www666www6661/WEILAI_SuperCap/hardware/SuperCap_Power/SuperCap_Power.kicad_pcb

## KiCad design hardware/SuperCap_Power/SuperCap_Power.kicad_pcb (2026-07-01)

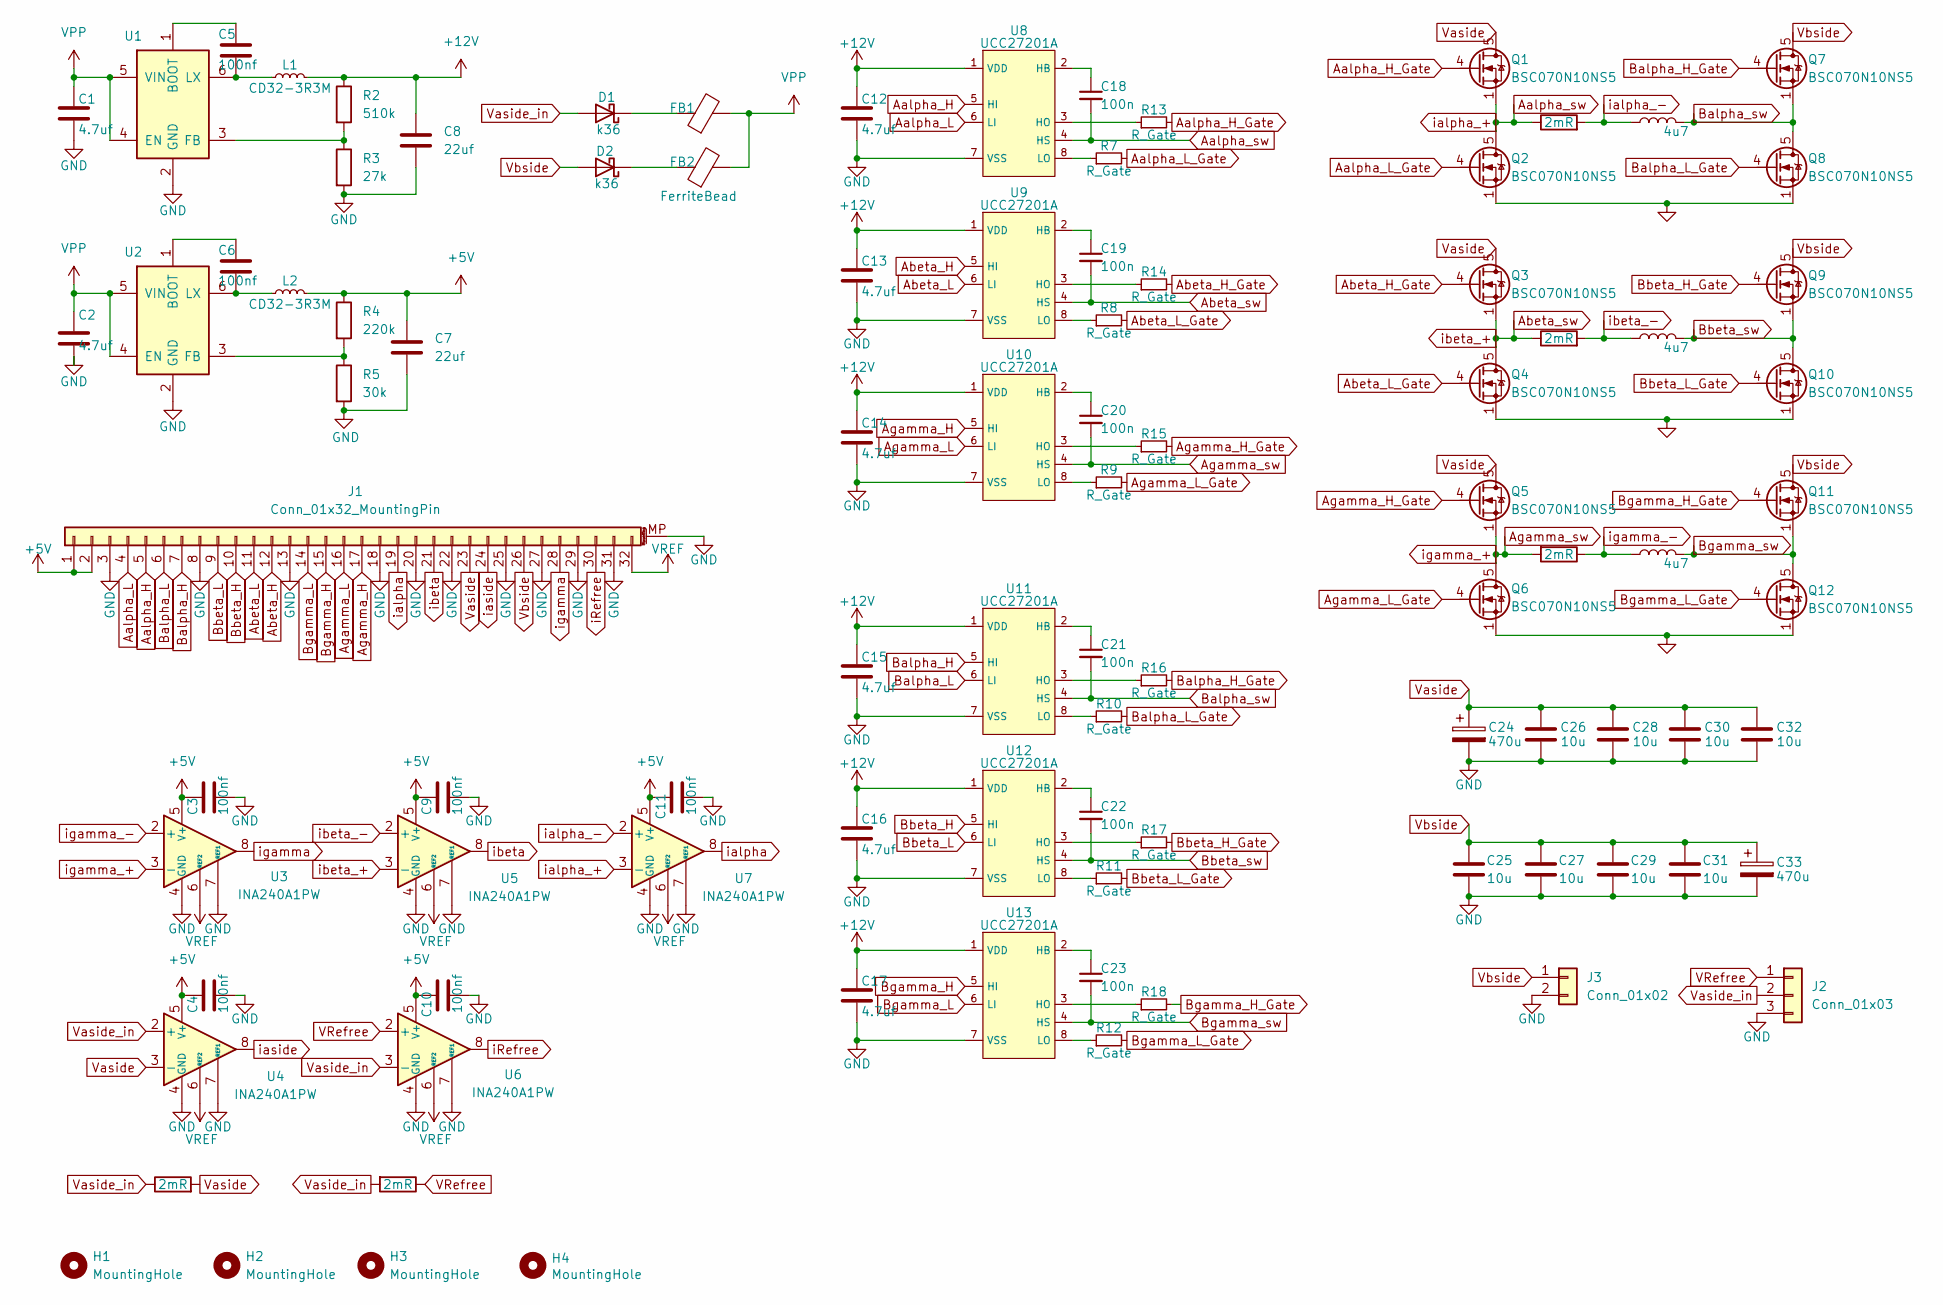
[picture p1: schematic SuperCap_Power.kicad_sch]

Parts:
C1, C2: 4.7uf; C_0805_2012Metric
C3, C4, C5, C6, C9, C10, C11: 100nf; C_0603_1608Metric_Pad1.08x0.95mm_HandSolder
C7, C8: 22uf; C_0603_1608Metric_Pad1.08x0.95mm_HandSolder
C12, C13, C14, C15, C16, C17: 4.7uf; C_0603_1608Metric_Pad1.08x0.95mm_HandSolder
C18, C19, C20, C21, C22, C23: 100n; C_0603_1608Metric
C24, C33: 470u; C_Radial_D10.0mm_H20.0mm_P5.00mm
C25, C26, C27, C28, C29, C30, C31, C32: 10u; C_1206_3216Metric
D1, D2: k36; D_SOD-123F
FB1, FB2: FerriteBead; L_0603_1608Metric
H1, H2, H3, H4: MountingHole; MountingHole_3.2mm_M3
J1: Conn_01x32_MountingPin; Hirose_FH12-32S-0.5SH_1x32-1MP_P0.50mm_Horizontal
J2: Conn_01x03; 1_03
J3: Conn_01x02; 01_02
L1, L2: CD32-3R3M; tolerance 20 %; MPN CD32-3R3M
L3, L4, L5: 4u7; L_Bourns_SRP1050WA
Q1, Q2, Q3, Q4, Q5, Q6, Q7, Q8, Q9, Q10, Q11, Q12: BSC070N10NS5; TDSON-8-1
R1, R6, R19, R20, R21: 2mR; R_0612_1632Metric
R2: 510k; R_0603_1608Metric_Pad0.98x0.95mm_HandSolder
R3: 27k; R_0603_1608Metric_Pad0.98x0.95mm_HandSolder
R4: 220k; R_0603_1608Metric_Pad0.98x0.95mm_HandSolder
R5: 30k; R_0603_1608Metric_Pad0.98x0.95mm_HandSolder
R7, R8, R9, R10, R11, R12, R13, R14, R15, R16, R17, R18: R_Gate; R_0603_1608Metric
U1, U2: ME3121AM6G; SOT-23-6; MPN ME3121AM6G
U3, U4, U5, U6, U7: INA240A1PW; TSSOP-8_4.4x3mm_P0.65mm
U8, U9, U10, U11, U12, U13: UCC27201A; SOIC-8_3.9x4.9mm_P1.27mm

Connections:
+5V: C3.2, C4.2, C7.2, C9.2, C10.2, C11.2, J1.1, J1.2, L2.2, R4.1, U3.5 (V+), U4.5 (V+), U5.5 (V+), U6.5 (V+), U7.5 (V+)
+12V: C8.2, C12.1, C13.1, C14.1, C15.1, C16.1, C17.1, L1.2, R2.1, U8.1 (VDD), U9.1 (VDD), U10.1 (VDD), U11.1 (VDD), U12.1 (VDD), U13.1 (VDD)
Aalpha_H: J1.5, U8.5 (HI)
Aalpha_H_Gate: Q1.4 (G), R13.2
Aalpha_L: J1.4, U8.6 (LI)
Aalpha_L_Gate: Q2.4 (G), R7.2
Aalpha_sw: C18.2, Q1.1 (S), Q1.2 (S), Q1.3 (S), Q2.5 (D), R19.1, U7.3 (-), U8.4 (HS)
Abeta_H: J1.12, U9.5 (HI)
Abeta_H_Gate: Q3.4 (G), R14.2
Abeta_L: J1.11, U9.6 (LI)
Abeta_L_Gate: Q4.4 (G), R8.2
Abeta_sw: C19.2, Q3.1 (S), Q3.2 (S), Q3.3 (S), Q4.5 (D), R20.1, U5.3 (-), U9.4 (HS)
Agamma_H: J1.17, U10.5 (HI)
Agamma_H_Gate: Q5.4 (G), R15.2
Agamma_L: J1.16, U10.6 (LI)
Agamma_L_Gate: Q6.4 (G), R9.2
Agamma_sw: C20.2, Q5.1 (S), Q5.2 (S), Q5.3 (S), Q6.5 (D), R21.2, U3.3 (-), U10.4 (HS)
Balpha_H: J1.7, U11.5 (HI)
Balpha_H_Gate: Q7.4 (G), R16.2
Balpha_L: J1.6, U11.6 (LI)
Balpha_L_Gate: Q8.4 (G), R10.2
Balpha_sw: C21.2, L3.2, Q7.1 (S), Q7.2 (S), Q7.3 (S), Q8.5 (D), U11.4 (HS)
Bbeta_H: J1.10, U12.5 (HI)
Bbeta_H_Gate: Q9.4 (G), R17.2
Bbeta_L: J1.9, U12.6 (LI)
Bbeta_L_Gate: Q10.4 (G), R11.2
Bbeta_sw: C22.2, L4.2, Q9.1 (S), Q9.2 (S), Q9.3 (S), Q10.5 (D), U12.4 (HS)
Bgamma_H: J1.15, U13.5 (HI)
Bgamma_H_Gate: Q11.4 (G), R18.2
Bgamma_L: J1.14, U13.6 (LI)
Bgamma_L_Gate: Q12.4 (G), R12.2
Bgamma_sw: C23.2, L5.2, Q11.1 (S), Q11.2 (S), Q11.3 (S), Q12.5 (D), U13.4 (HS)
GND: C1.2, C2.2, C3.1, C4.1, C7.1, C8.1, C9.1, C10.1, C11.1, C12.2, C13.2, C14.2, C15.2, C16.2, C17.2, C24.2, C25.1, C26.1, C27.1, C28.1, C29.1, C30.1, C31.1, C32.1, C33.2, J1.3, J1.8, J1.13, J1.18, J1.20, J1.22, J1.25, J1.27, J1.29, J1.31, J1.MP (MountPin), J2.3, J3.2, Q2.1 (S), Q2.2 (S), Q2.3 (S), Q4.1 (S), Q4.2 (S), Q4.3 (S), Q6.1 (S), Q6.2 (S), Q6.3 (S), Q8.1 (S), Q8.2 (S), Q8.3 (S), Q10.1 (S), Q10.2 (S), Q10.3 (S), Q12.1 (S), Q12.2 (S), Q12.3 (S), R3.2, R5.2, U1.2 (GND), U2.2 (GND), U3.1 (GND), U3.4 (GND), U3.7 (REF1), U4.1 (GND), U4.4 (GND), U4.7 (REF1), U5.1 (GND), U5.4 (GND), U5.7 (REF1), U6.1 (GND), U6.4 (GND), U6.7 (REF1), U7.1 (GND), U7.4 (GND), U7.7 (REF1), U8.7 (VSS), U9.7 (VSS), U10.7 (VSS), U11.7 (VSS), U12.7 (VSS), U13.7 (VSS)
unnamed: D1.1 (K), FB1.1
unnamed: D2.1 (K), FB2.1
unnamed: C5.2, U1.1 (BOOT)
unnamed: R2.2, R3.1, U1.3 (FB)
unnamed: C5.1, L1.1, U1.6 (LX)
unnamed: C6.2, U2.1 (BOOT)
unnamed: R4.2, R5.1, U2.3 (FB)
unnamed: C6.1, L2.1, U2.6 (LX)
unnamed: C18.1, U8.2 (HB)
unnamed: R13.1, U8.3 (HO)
unnamed: R7.1, U8.8 (LO)
unnamed: C19.1, U9.2 (HB)
unnamed: R14.1, U9.3 (HO)
unnamed: R8.1, U9.8 (LO)
unnamed: C20.1, U10.2 (HB)
unnamed: R15.1, U10.3 (HO)
unnamed: R9.1, U10.8 (LO)
unnamed: C21.1, U11.2 (HB)
unnamed: R16.1, U11.3 (HO)
unnamed: R10.1, U11.8 (LO)
unnamed: C22.1, U12.2 (HB)
unnamed: R17.1, U12.3 (HO)
unnamed: R11.1, U12.8 (LO)
unnamed: C23.1, U13.2 (HB)
unnamed: R18.1, U13.3 (HO)
unnamed: R12.1, U13.8 (LO)
VPP: C1.1, C2.1, FB1.2, FB2.2, U1.4 (EN), U1.5 (VIN), U2.4 (EN), U2.5 (VIN)
VREF: J1.32, U3.6 (REF2), U4.6 (REF2), U5.6 (REF2), U6.6 (REF2), U7.6 (REF2)
VRefree: J2.1, R6.1, U6.2 (+)
Vaside: C24.1, C26.2, C28.2, C30.2, C32.2, J1.23, Q1.5 (D), Q3.5 (D), Q5.5 (D), R1.2, U4.3 (-)
Vaside_in: D1.2 (A), J2.2, R1.1, R6.2, U4.2 (+), U6.3 (-)
Vbside: C25.2, C27.2, C29.2, C31.2, C33.1, D2.2 (A), J1.26, J3.1, Q7.5 (D), Q9.5 (D), Q11.5 (D)
iRefree: J1.30, U6.8
ialpha: J1.19, U7.8
ialpha_-: L3.1, R19.2, U7.2 (+)
iaside: J1.24, U4.8
ibeta: J1.21, U5.8
ibeta_-: L4.1, R20.2, U5.2 (+)
igamma: J1.28, U3.8
igamma_-: L5.1, R21.1, U3.2 (+)

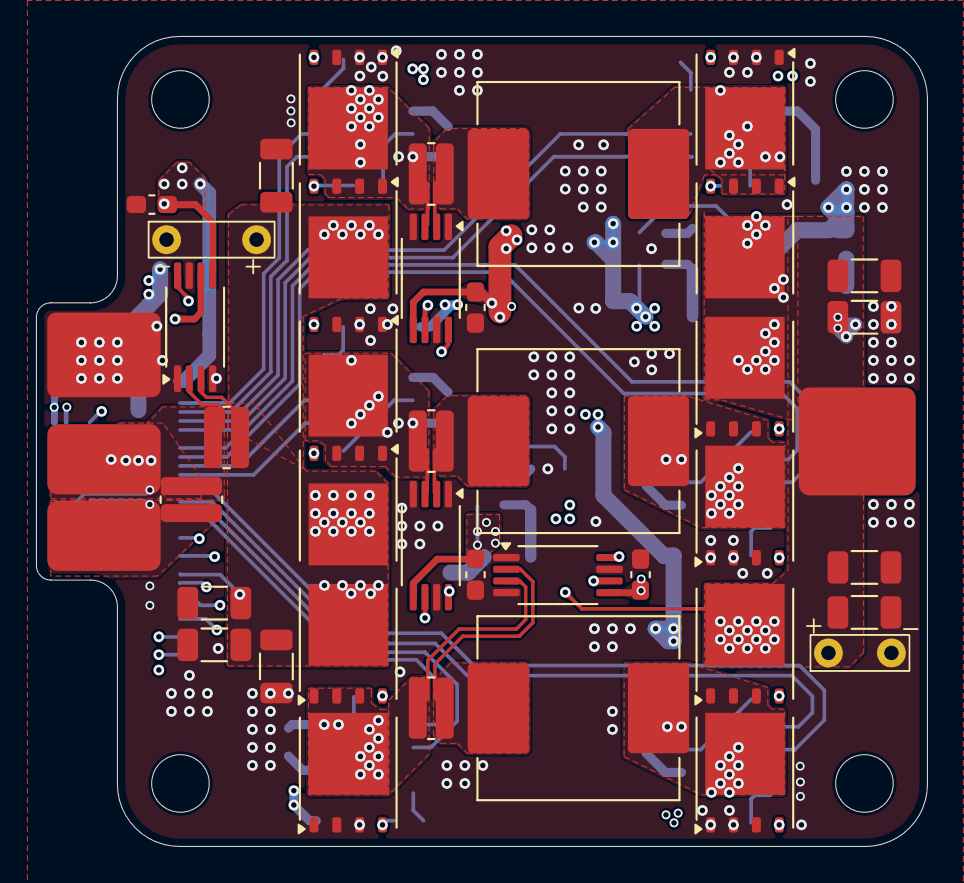
[picture p2: board SuperCap_Power.kicad_pcb from above]

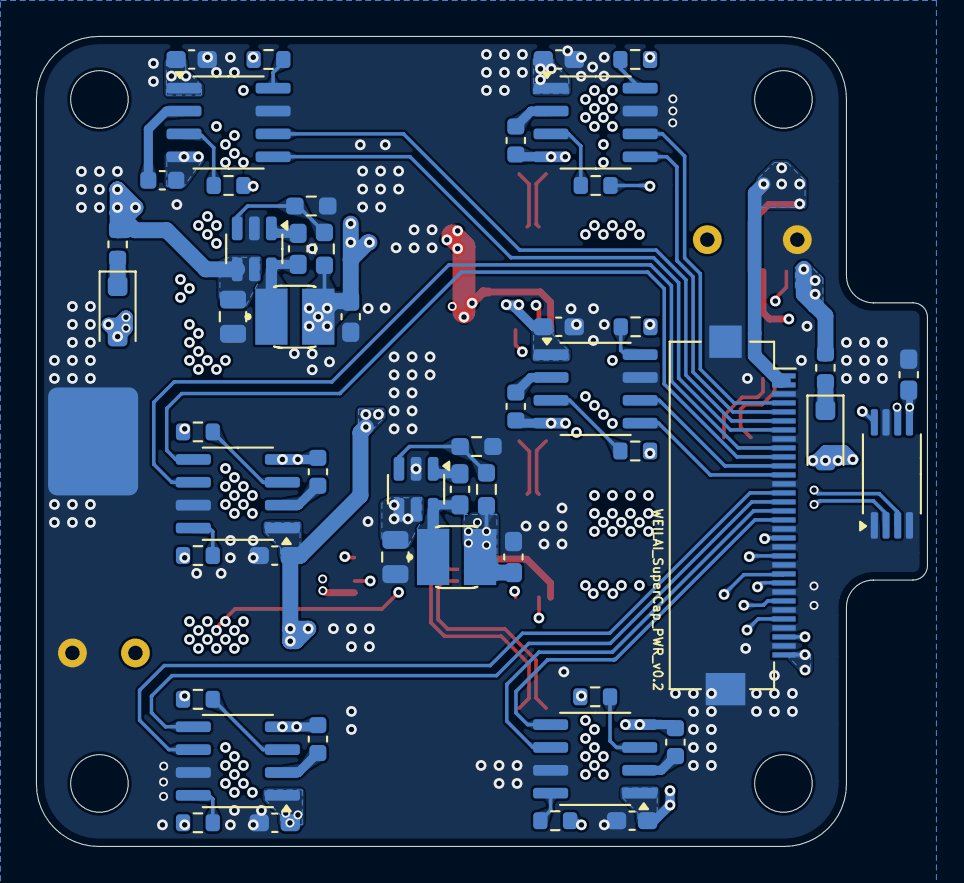
[picture p3: board SuperCap_Power.kicad_pcb from below]

Board: 4 copper layers, 49.5 x 45.0 mm, 95 parts (51 on the bottom side), 73 nets.
