www666www6661/WEILAI_SuperCap/hardware/SuperCap_Ctrl/SuperCap_Ctrl.kicad_pcb

## KiCad design hardware/SuperCap_Ctrl/SuperCap_Ctrl.kicad_pcb (2026-07-01)

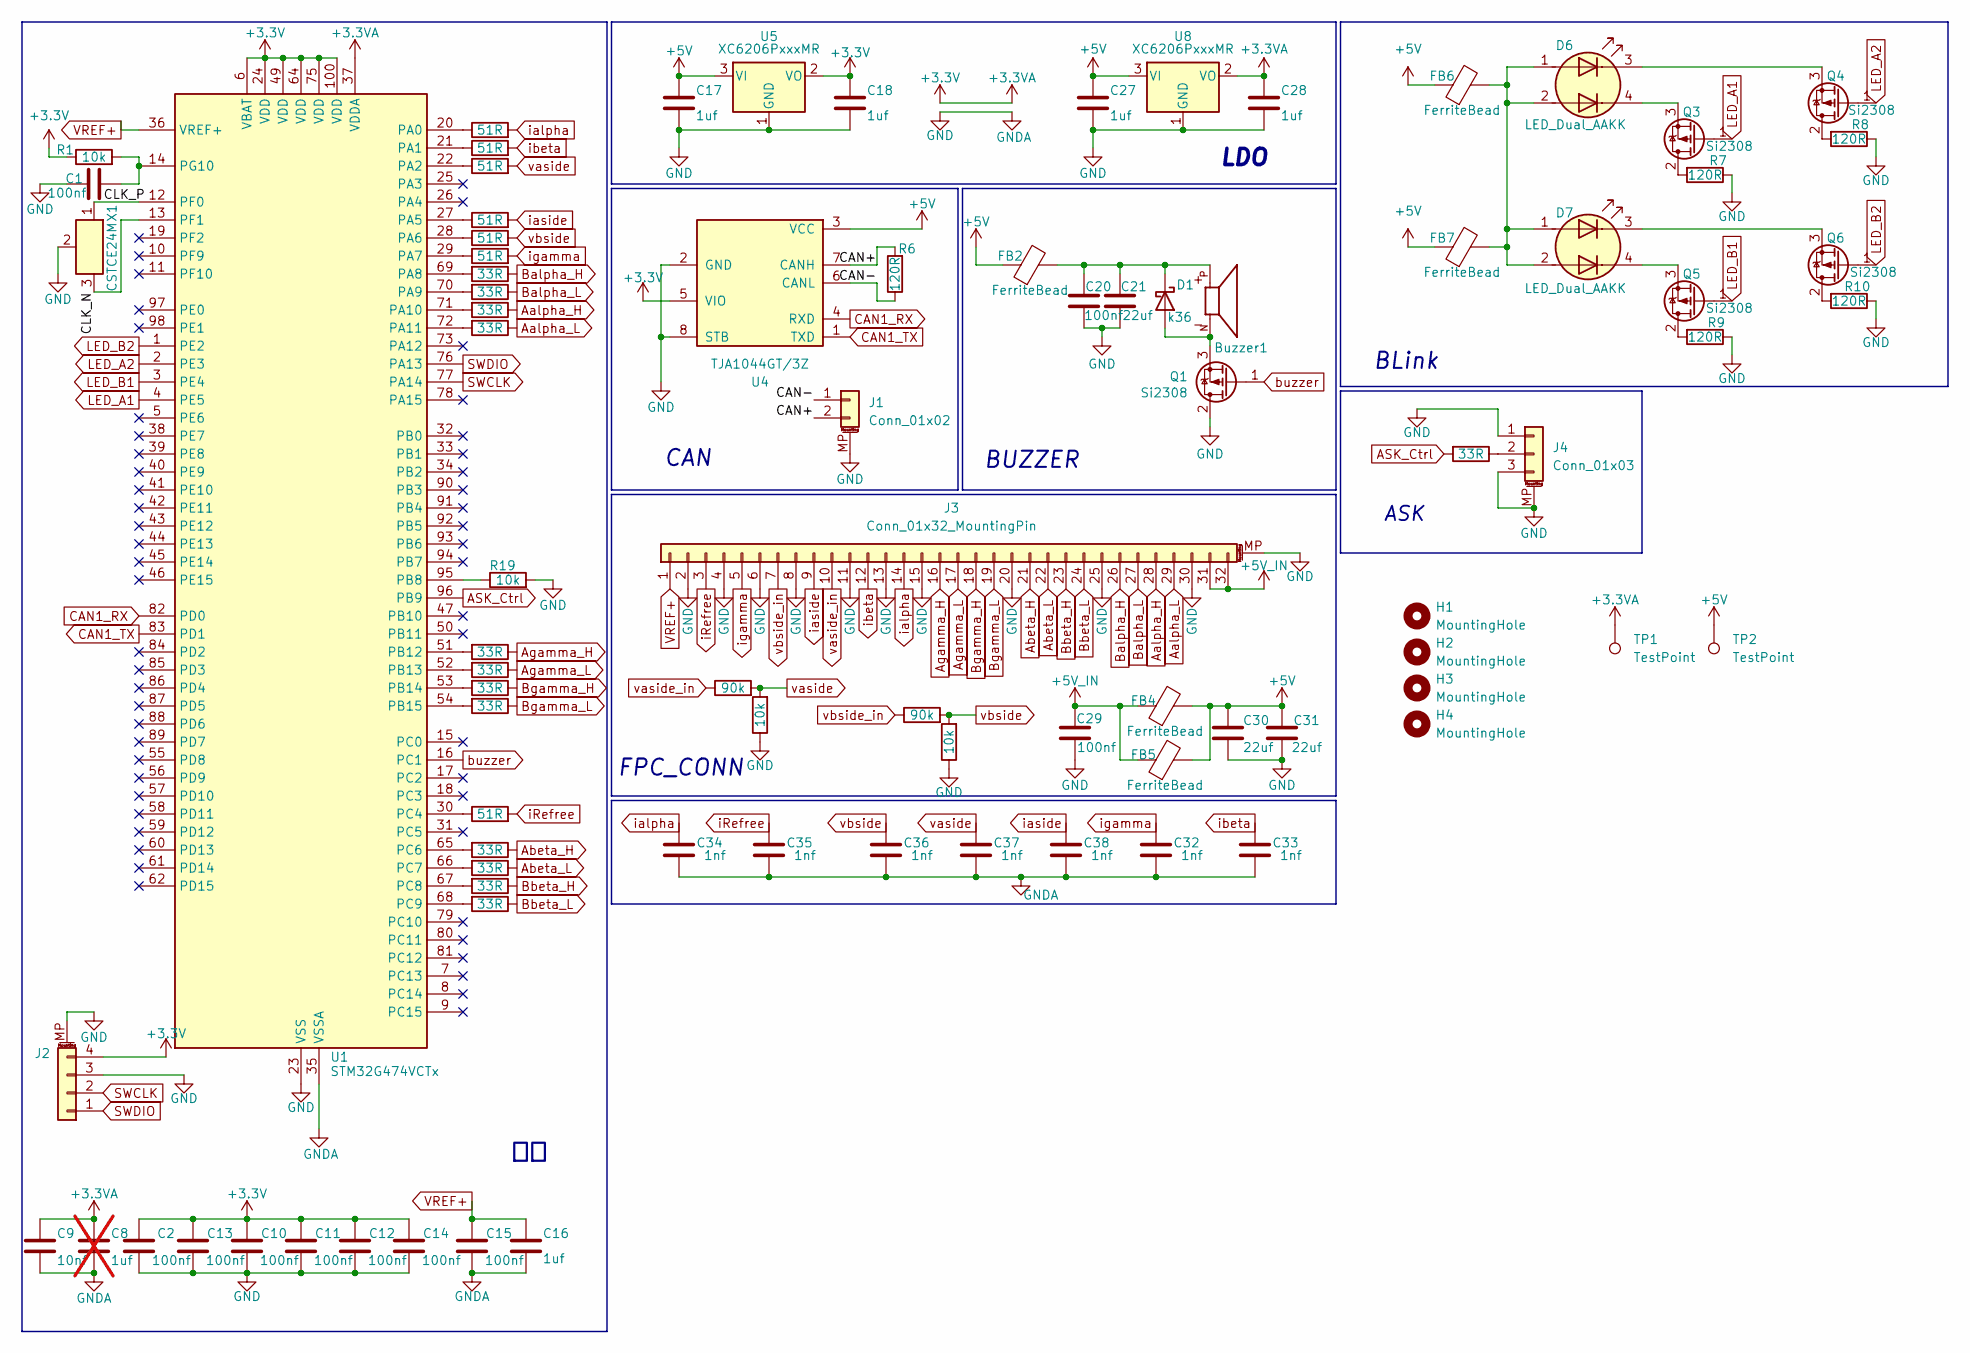
[picture p4: schematic SuperCap_Ctrl.kicad_sch]

Parts:
Buzzer1: CMT-7525-80-SMT-TR; XDCR_CMT-7525-80-SMT-TR; PARTREV N/A
C1, C2, C10, C11, C12, C13, C14, C15, C20, C29: 100nf; C_0603_1608Metric_Pad1.08x0.95mm_HandSolder
C8: 1uf; C_0603_1608Metric_Pad1.08x0.95mm_HandSolder; not fitted
C9: 10nf; C_0603_1608Metric_Pad1.08x0.95mm_HandSolder
C16, C17, C18, C27, C28: 1uf; C_0603_1608Metric_Pad1.08x0.95mm_HandSolder
C21, C30, C31: 22uf; C_0603_1608Metric_Pad1.08x0.95mm_HandSolder
C32, C33, C34, C35, C36, C37, C38: 1nf; C_0603_1608Metric_Pad1.08x0.95mm_HandSolder
D1: k36; D_SOD-123F
D6, D7: LED_Dual_AAKK; LED_Avago_PLCC4_3.2x2.8mm_CW
FB2, FB4, FB5, FB6, FB7: FerriteBead; L_0603_1608Metric
H1, H2, H3, H4: MountingHole; MountingHole_3.2mm_M3
J1: Conn_01x02; JST_GH_SM02B-GHS-TB_1x02-1MP_P1.25mm_Horizontal
J2: Conn_01x04; Molex_CLIK-Mate_502386-0470_1x04-1MP_P1.25mm_Horizontal
J3: Conn_01x32_MountingPin; Hirose_FH12-32S-0.5SH_1x32-1MP_P0.50mm_Horizontal
J4: Conn_01x03; JST_GH_SM03B-GHS-TB_1x03-1MP_P1.25mm_Horizontal
Q1, Q3, Q4, Q5, Q6: Si2308; SOT-23
R1, R12, R19: 10k; R_0603_1608Metric
R2, R30, R31, R32, R33, R34, R35, R36, R37, R38, R39, R40, R41: 33R; R_0603_1608Metric_Pad0.98x0.95mm_HandSolder
R3, R11: 90k; R_0603_1608Metric
R4: 10k; R_0603_1608Metric_Pad0.98x0.95mm_HandSolder
R6, R7, R8, R9, R10: 120R; R_0603_1608Metric_Pad0.98x0.95mm_HandSolder
R23, R24, R25, R26, R27, R28, R29: 51R; R_0603_1608Metric_Pad0.98x0.95mm_HandSolder
TP1, TP2: TestPoint; TestPoint_Pad_D1.0mm
U1: STM32G474VCTx; LQFP-100_14x14mm_P0.5mm
U4: TJA1044GT/3Z; SOIC-8_3.9x4.9mm_P1.27mm; MPN TJA1044GT/3Z
U5, U8: XC6206PxxxMR; SOT-23-3
X1: CSTCE24M; OSC_CSTCE8M00G55-R0; tolerance 0.1 %; MPN CSTCE8M00G15C99-R0

Connections:
+3.3V: C2.1, C8.2, C9.2, C10.1, C11.1, C12.1, C13.1, C14.1, C18.2, C28.2, J2.4, R1.1, TP1.1, U1.6 (VBAT), U1.24 (VDD), U1.37 (VDDA), U1.49 (VDD), U1.64 (VDD), U1.75 (VDD), U1.100 (VDD), U4.5 (VIO), U5.2 (VO), U8.2 (VO)
+5V: C17.2, C27.2, C30.2, C31.2, FB2.1, FB4.2, FB5.2, FB6.1, FB7.1, TP2.1, U4.3 (VCC), U5.3 (VI), U8.3 (VI)
+5V_IN: C29.1, FB4.1, FB5.1, J3.31, J3.32
/CAN+: J1.2, R6.2, U4.7 (CANH)
/CAN-: J1.1, R6.1, U4.6 (CANL)
/CLK_N: U1.13 (PF1), X1.3
/CLK_P: U1.12 (PF0), X1.1
ASK_Ctrl: R2.2, U1.96 (PB9)
Aalpha_H: J3.28, R40.1
Aalpha_L: J3.29, R41.1
Abeta_H: J3.21, R30.1
Abeta_L: J3.22, R31.1
Agamma_H: J3.16, R34.1
Agamma_L: J3.17, R35.1
Balpha_H: J3.26, R38.1
Balpha_L: J3.27, R39.1
Bbeta_H: J3.23, R32.1
Bbeta_L: J3.24, R33.1
Bgamma_H: J3.18, R36.1
Bgamma_L: J3.19, R37.1
CAN1_RX: U1.82 (PD0), U4.4 (RXD)
CAN1_TX: U1.83 (PD1), U4.1 (TXD)
GND: C1.2, C2.2, C8.1, C9.1, C10.2, C11.2, C12.2, C13.2, C14.2, C15.2, C16.1, C17.1, C18.1, C20.2, C21.1, C27.1, C28.1, C29.2, C30.1, C31.1, C32.2, C33.2, C34.2, C35.2, C36.2, C37.2, C38.2, J1.MP (MountPin), J2.3, J2.MP (MountPin), J3.2, J3.4, J3.6, J3.8, J3.11, J3.13, J3.15, J3.20, J3.25, J3.30, J3.MP (MountPin), J4.1, J4.3, J4.MP (MountPin), Q1.2 (D), R4.1, R7.1, R8.1, R9.1, R10.1, R12.1, R19.2, U1.23 (VSS), U1.35 (VSSA), U1.48 (VSS), U1.63 (VSS), U1.74 (VSS), U1.99 (VSS), U4.2 (GND), U4.8 (STB), U5.1 (GND), U8.1 (GND), X1.2
LED_A1: Q3.1 (G), U1.4 (PE5)
LED_A2: Q4.1 (G), U1.2 (PE3)
LED_B1: Q5.1 (G), U1.3 (PE4)
LED_B2: Q6.1 (G), U1.1 (PE2)
unnamed: Buzzer1.N, D1.2 (A), Q1.3 (S)
unnamed: Buzzer1.P, C20.1, C21.2, D1.1 (K), FB2.2
unnamed: D6.1 (A1), D6.2 (A2), D7.1 (A1), D7.2 (A2), FB6.2, FB7.2
unnamed: D6.3 (K1), Q4.3 (S)
unnamed: D6.4 (K2), Q3.3 (S)
unnamed: D7.3 (K1), Q6.3 (S)
unnamed: D7.4 (K2), Q5.3 (S)
unnamed: J4.2, R2.1
unnamed: Q3.2 (D), R7.2
unnamed: Q4.2 (D), R8.2
unnamed: Q5.2 (D), R9.2
unnamed: Q6.2 (D), R10.2
unnamed: R23.1, U1.20 (PA0)
unnamed: R24.1, U1.21 (PA1)
unnamed: R25.1, U1.22 (PA2)
unnamed: R29.1, U1.27 (PA5)
unnamed: R27.1, U1.28 (PA6)
unnamed: R28.1, U1.29 (PA7)
unnamed: R38.2, U1.69 (PA8)
unnamed: R39.2, U1.70 (PA9)
unnamed: R40.2, U1.71 (PA10)
unnamed: R41.2, U1.72 (PA11)
unnamed: R19.1, U1.95 (PB8)
unnamed: R34.2, U1.51 (PB12)
unnamed: R35.2, U1.52 (PB13)
unnamed: R36.2, U1.53 (PB14)
unnamed: R37.2, U1.54 (PB15)
unnamed: R26.1, U1.30 (PC4)
unnamed: R30.2, U1.65 (PC6)
unnamed: R31.2, U1.66 (PC7)
unnamed: R32.2, U1.67 (PC8)
unnamed: R33.2, U1.68 (PC9)
unnamed: C1.1, R1.2, U1.14 (PG10)
SWCLK: J2.2, U1.77 (PA14)
SWDIO: J2.1, U1.76 (PA13)
VREF+: C15.1, C16.2, J3.1, U1.36 (VREF+)
buzzer: Q1.1 (G), U1.16 (PC1)
iRefree: C35.1, J3.3, R26.2
ialpha: C34.1, J3.14, R23.2
iaside: C38.1, J3.9, R29.2
ibeta: C33.1, J3.12, R24.2
igamma: C32.1, J3.5, R28.2
vaside: C37.1, R3.2, R4.2, R25.2
vaside_in: J3.10, R3.1
vbside: C36.1, R11.2, R12.2, R27.2
vbside_in: J3.7, R11.1

Notes on the sheet:
BUZZER
LDO
CAN
FPC_CONN
BLink
ASK

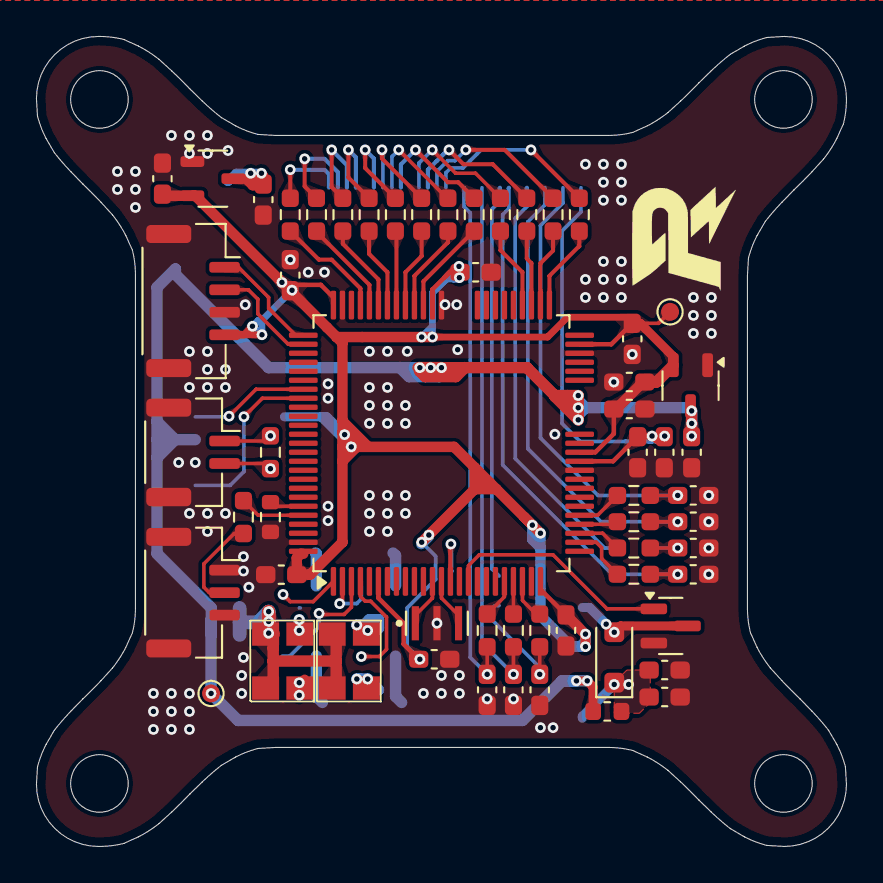
[picture p5: board SuperCap_Ctrl.kicad_pcb from above]

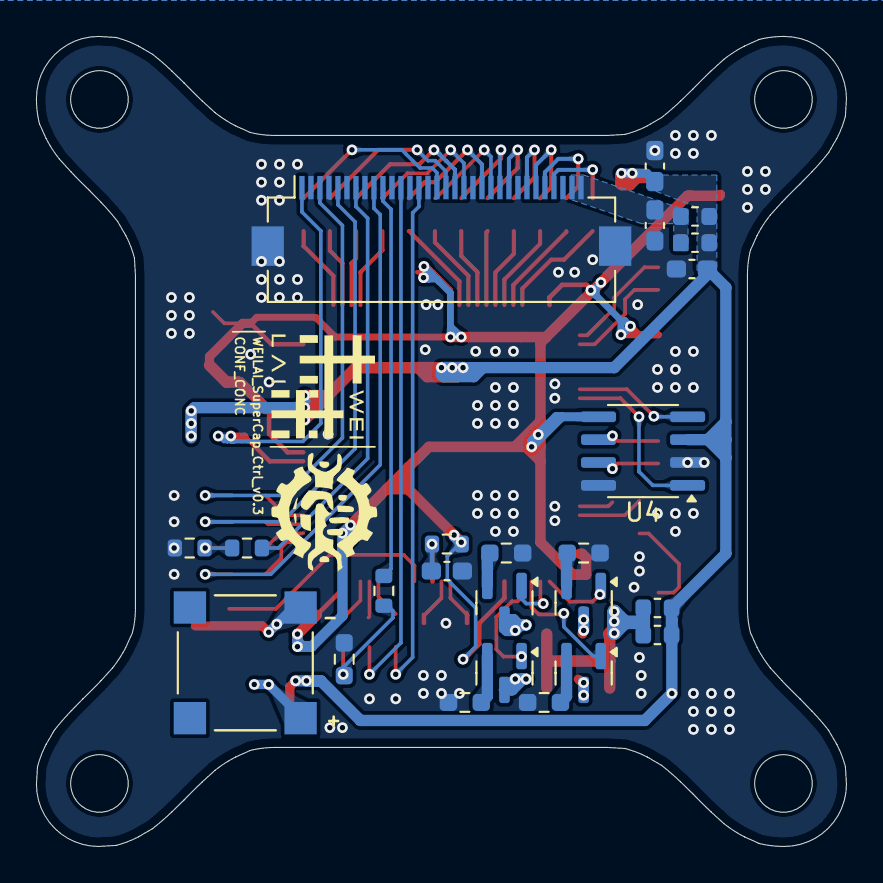
[picture p6: board SuperCap_Ctrl.kicad_pcb from below]

Board: 2 copper layers, 45.0 x 45.0 mm, 86 parts (24 on the bottom side), 73 nets.
