www666www6661/WEILAI_SuperCap/software/SuperCap_WEILAI.ioc

Mcu.UserName=STM32G474VCTx
PA0.Signal=ADC1_IN1
PA1.Signal=ADC1_IN2
PA10.Signal=HRTIM1_CHB1
PA11.Signal=HRTIM1_CHB2
PA13.Signal=SYS_JTMS-SWDIO
PA14.Signal=SYS_JTCK-SWCLK
PA2.Signal=ADC1_IN3
PA5.Signal=ADC2_IN13
PA6.Signal=ADC2_IN3
PA7.Signal=ADC2_IN4
PA8.Signal=HRTIM1_CHA1
PA9.Signal=HRTIM1_CHA2
PB12.Signal=HRTIM1_CHC1
PB13.Signal=HRTIM1_CHC2
PB14.Signal=HRTIM1_CHD1
PB15.Signal=HRTIM1_CHD2
PB3.Signal=USART2_TX
PB4.Signal=USART2_RX
PB9.Signal=TIM1_CH3N
PC1.Signal=S_TIM1_CH2
PC2.Signal=ADC1_IN8
PC4.Signal=ADC2_IN5
PC6.Signal=HRTIM1_CHF1
PC7.Signal=HRTIM1_CHF2
PC8.Signal=HRTIM1_CHE1
PC9.Signal=HRTIM1_CHE2
PD0.Signal=FDCAN1_RX
PD1.Signal=FDCAN1_TX
PE2.Signal=GPIO_Output
PE3.Signal=GPIO_Output
PE4.Signal=GPIO_Output
PE5.Signal=GPIO_Output
PF0-OSC_IN.Signal=RCC_OSC_IN
PF1-OSC_OUT.Signal=RCC_OSC_OUT
