www666www6661/WEILAI_SuperCap/(commit log)

2026-03-03 超电上板 v0.1
    [SuperCap_Ctrl-B_Cu.gbl, SuperCap_Ctrl-B_Mask.gbs, SuperCap_Ctrl-B_Paste.gbp, SuperCap_Ctrl-B_Silkscreen.gbo, SuperCap_Ctrl-Edge_Cuts.gm1, SuperCap_Ctrl-F_Cu.gtl, SuperCap_Ctrl-F_Mask.gts, SuperCap_Ctrl-F_Paste.gtp]
2026-03-03 超电下板 v0.1
    [SuperCap_Power-B_Cu.gbl, SuperCap_Power-B_Mask.gbs, SuperCap_Power-B_Paste.gbp, SuperCap_Power-B_Silkscreen.gbo, SuperCap_Power-Edge_Cuts.gm1, SuperCap_Power-F_Cu.gtl, SuperCap_Power-F_Mask.gts, SuperCap_Power-F_Paste.gtp]
2026-03-28 将3D模型保存到项目目录,修复了mos的问题
    [SuperCap_Ctrl.csv]
2026-03-28 wip: before subtree sync
    [SuperCap_Ctrl.kicad_pcb, SuperCap_Ctrl.kicad_sch]
2026-03-28 更新上板,将上板的3D模型存入项目文件夹
2026-03-28 修改LED电路
    [SuperCap_Ctrl.kicad_pcb, SuperCap_Ctrl.kicad_sch]
2026-03-28 修改LED电路_1
    [SuperCap_Ctrl-B_Cu.gbl, SuperCap_Ctrl-B_Mask.gbs, SuperCap_Ctrl-B_Paste.gbp, SuperCap_Ctrl-B_Silkscreen.gbo, SuperCap_Ctrl-Edge_Cuts.gm1, SuperCap_Ctrl-F_Cu.gtl, SuperCap_Ctrl-F_Mask.gts, SuperCap_Ctrl-F_Paste.gtp]
2026-07-01 RMUC version
    [SuperCap_Ctrl-B_Cu.gbl, SuperCap_Ctrl-B_Mask.gbs, SuperCap_Ctrl-B_Paste.gbp, SuperCap_Ctrl-B_Silkscreen.gbo, SuperCap_Ctrl-Edge_Cuts.gm1, SuperCap_Ctrl-F_Cu.gtl, SuperCap_Ctrl-F_Mask.gts, SuperCap_Ctrl-F_Paste.gtp]
2026-07-01 chore: ignore generated hardware files
    [SuperCap_Power-B_Cu.gbl, SuperCap_Power-B_Mask.gbs, SuperCap_Power-B_Paste.gbp, SuperCap_Power-B_Silkscreen.gbo, SuperCap_Power-Edge_Cuts.gm1, SuperCap_Power-F_Cu.gtl, SuperCap_Power-F_Mask.gts, SuperCap_Power-F_Paste.gtp]
2026-07-01 update 3D models
    [SuperCap_Power.csv, SuperCap_Power.kicad_pcb]
2026-07-01 Squashed 'software/' content from commit 6cdf888
    git-subtree-dir: software
    git-subtree-split: 6cdf888e9de6c93451063e650564080c0eedee75
    [Ozone_DataSampling_260506.csv]
2026-07-01 Squashed 'software/' changes from 6cdf888..b7e2633
    b7e2633 RMUC version,更改电流均流策略
    git-subtree-split: b7e2633a36aff540aaaf07aaf0189e940e4b9b91
    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
2026-07-01 Squashed 'software/' changes from b7e2633..5f59ec9
    5f59ec9 delete Debug files
    git-subtree-split: 5f59ec977da8b5e6c22272c719c12f343f8ad704
    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
    [Ozone_DataSampling_260506.csv]
