www666www6661/WEILAI_SuperCap/(notices)

Notices in the files:
software/Core/Src/adc.c:
Copyright (c) 2026 STMicroelectronics.
All rights reserved.
This software is licensed under terms that can be found in the LICENSE file
